markqvist/OpenModem/(threads)

Thread 1 (2020-04-04):

feature request: please add compatibility with Navit

Supermagnum, 2020-04-04:
Navit is a free and open-source, modular, touch screen friendly, car navigation system with GPS tracking, realtime routing engine and support for various vector map formats. It features both a 2D and 3D view of map data.

Navit supports a variety of operating systems and hardware platforms.
It is currently not compatible with APRS.

Navits official web page:
https://www.navit-project.org/

Github page:
https://github.com/navit-gps

Navit Documentation:
http://doxygen.navit-project.org/

Link to the suggestion( patch request):
navit-gps/navit#982

markqvist, 2020-04-06:
I think this makes a lot of sense. I will commit to adding support for Navit to OpenModem. Since the OpenModem hardware also has a slot for a GPS module, and I already wrote the basic GPS driver and NMEA parsing into the OpenModem firmware, it'd be natural if OpenModem could function as both a GPS source for Navit and a APRS modem.

Supermagnum, 2020-04-08:
> I think this makes a lot of sense. I will commit to adding support for Navit to OpenModem. Since the OpenModem hardware also has a slot for a GPS module, and I already wrote the basic GPS driver and NMEA parsing into the OpenModem firmware, it'd be natural if OpenModem could function as both a GPS source for Navit and a APRS modem.

That would be great!
The folks at Navit still have to code the support for APRS symbols,I have no clue when that happens.

Closed 2024-02-29.

Thread 2 (2021-01-12):

Firmware from source code not decode packets.

demonwork, 2021-01-12:
The operation of the firmware obtained from the source code differs from the precompiled firmware. It does not decode packets.
When I connect with the configuration program to the precompiled firmware, in the Audio section I see what is shown in the OpenModem_AFSK1200_v1.05.hex.png screenshot.
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
When I connect the configuration program to the firmware from the source code, in the Audio section I see what is shown in the OpenModem.hex-from-source.png screenshot.
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

Perhaps this is somehow related.
I assembled the modem according to your scheme, but my cardholder is different. When there is no SD card in it, SD_DETECT is high, when the card is inserted, low. So I had to invert the card presence check and compile the firmware from the source code.

Everything works fine with precompiled firmware. Except for working with a SD card.

My build system is Ubuntu 18.04, avr-libc 2.0.0, gcc-avr 5.4.0.

demonwork, 2021-01-17:
Fixed the issue and some enhancement in pull request #3

markqvist, 2021-03-12:
Thanks for reporting it. I normally leave the master branch in a working order, but due to some new drivers, the head of the master branch was not decoding packets. Please always use the sources from the latest tagged release if something is wonky, in rare cases I might be in the middle of something in the head of the master branch ;) Either way, version 1.06 is released now and the issue is resolved. I'll have a look at the pull request later. Thanks for contributing.

Closed 2021-03-12.

Thread 6 (2022-12-28):

Plans to open source board layout files?

spaceinvadr, 2022-12-28:
Hey Mark, I want to start by saying I've been following your work on Reticulum and RNode for several years and am hugely appreciative of everything you have made available to the community. These projects have been hugely inspirational in my own personal projects and I'm looking forward to watching them continue to develop and enable more people to connect without reliance on internet systems.

I'm wondering if you have any plans to open-source the board files to enable people to assemble their own openmodem hardware. I realize this is a product you sell and even releasing the schematic files is generous. If you would rather not that is totally understandable.

markqvist, 2022-12-28:
Thank you very much for your encouraging comments!

That is something I am considering doing, but currently I'm not sure it would add much value, since it is really hard to source several of the parts needed to build the modem, especially the ATmega1284p MCU. I've been working on a redesign to use another chip, but with everything else going on, and priorities putting other work higher, it is not something that is near ready yet.

ahedproductions, 2023-11-10:
Hello!
This CPU is very much available now!
https://www.mouser.bg/ProductDetail/Microchip-Technology/ATMEGA1284P-AU?qs=K8BHR703ZXhSH38LfIFExQ%3D%3D
I would like to up the question.
Thank you!

Closed 2024-02-29.
