markqvist/OpenModem/documentation/Schematic.pdf

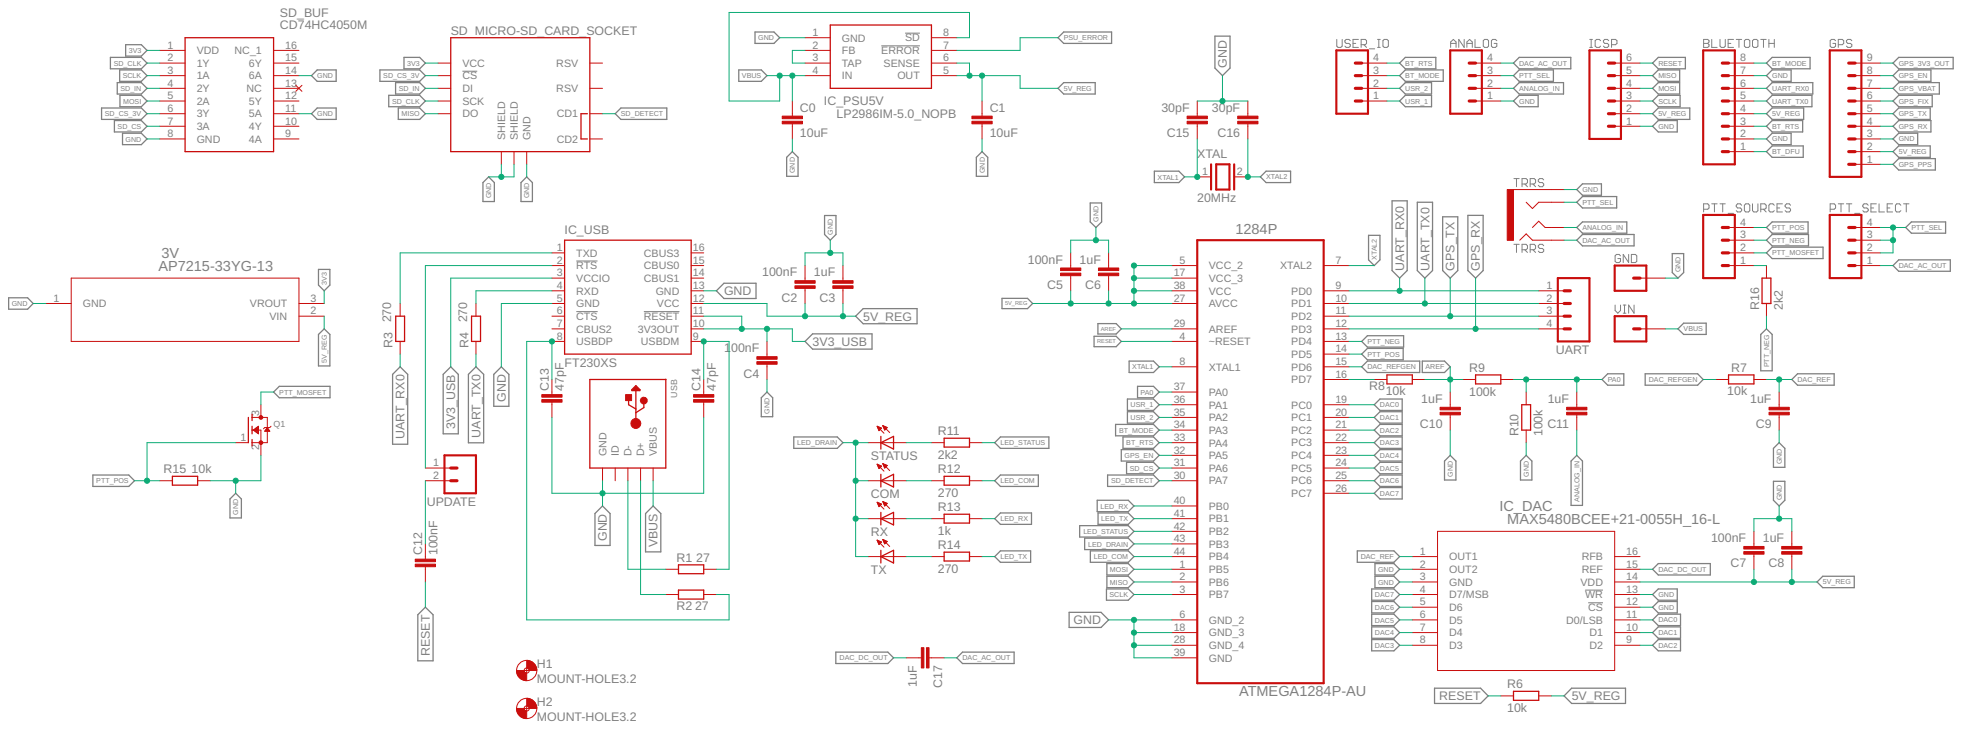
[picture p1: page 1]

RESET | PTT_NEG 14 PD6

USR_2 | DAC1 21 PC3

SD_CS | DAC5 25 PC7
