markqvist/OpenModem/documentation/OpenModem_Production_Layout.pdf

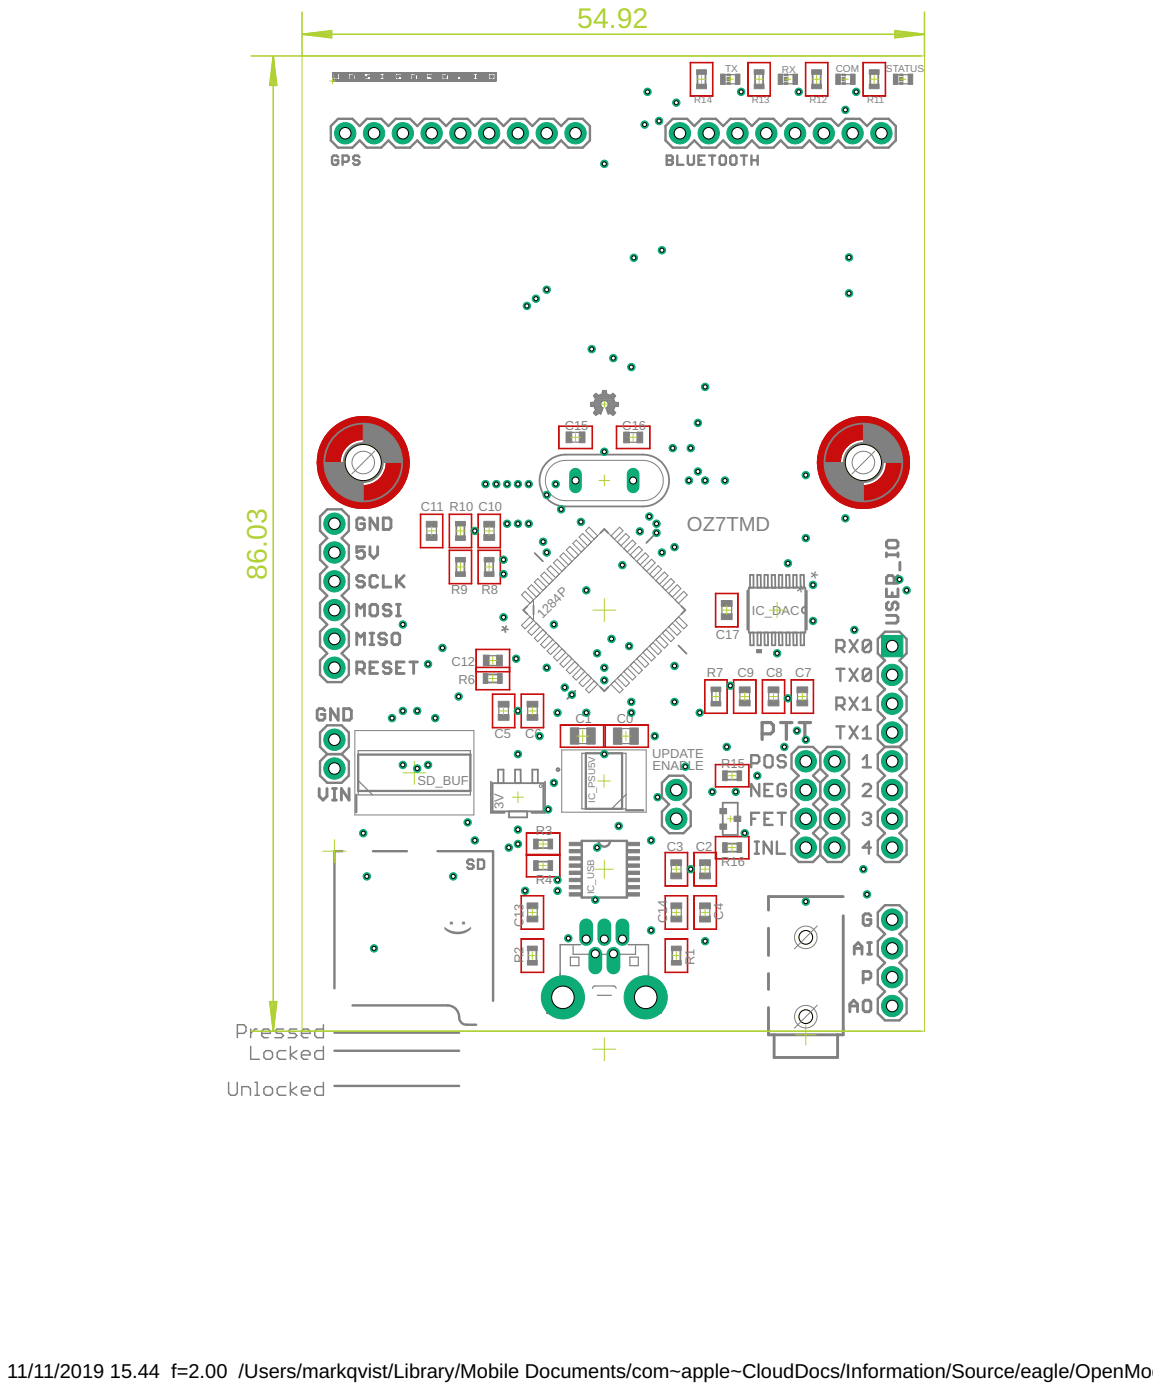
[picture p2: page 1]

11/11/2019 15.44 f=2.00 /Users/markqvist/Library/Mobile Documents/com~apple~CloudDocs/Information/Source/eagle/OpenModem/OpenModem.brd
