markqvist/OpenModem/documentation/OpenModem_Schematic.sch

## EAGLE design documentation/OpenModem_Schematic.sch (2020-04-30)

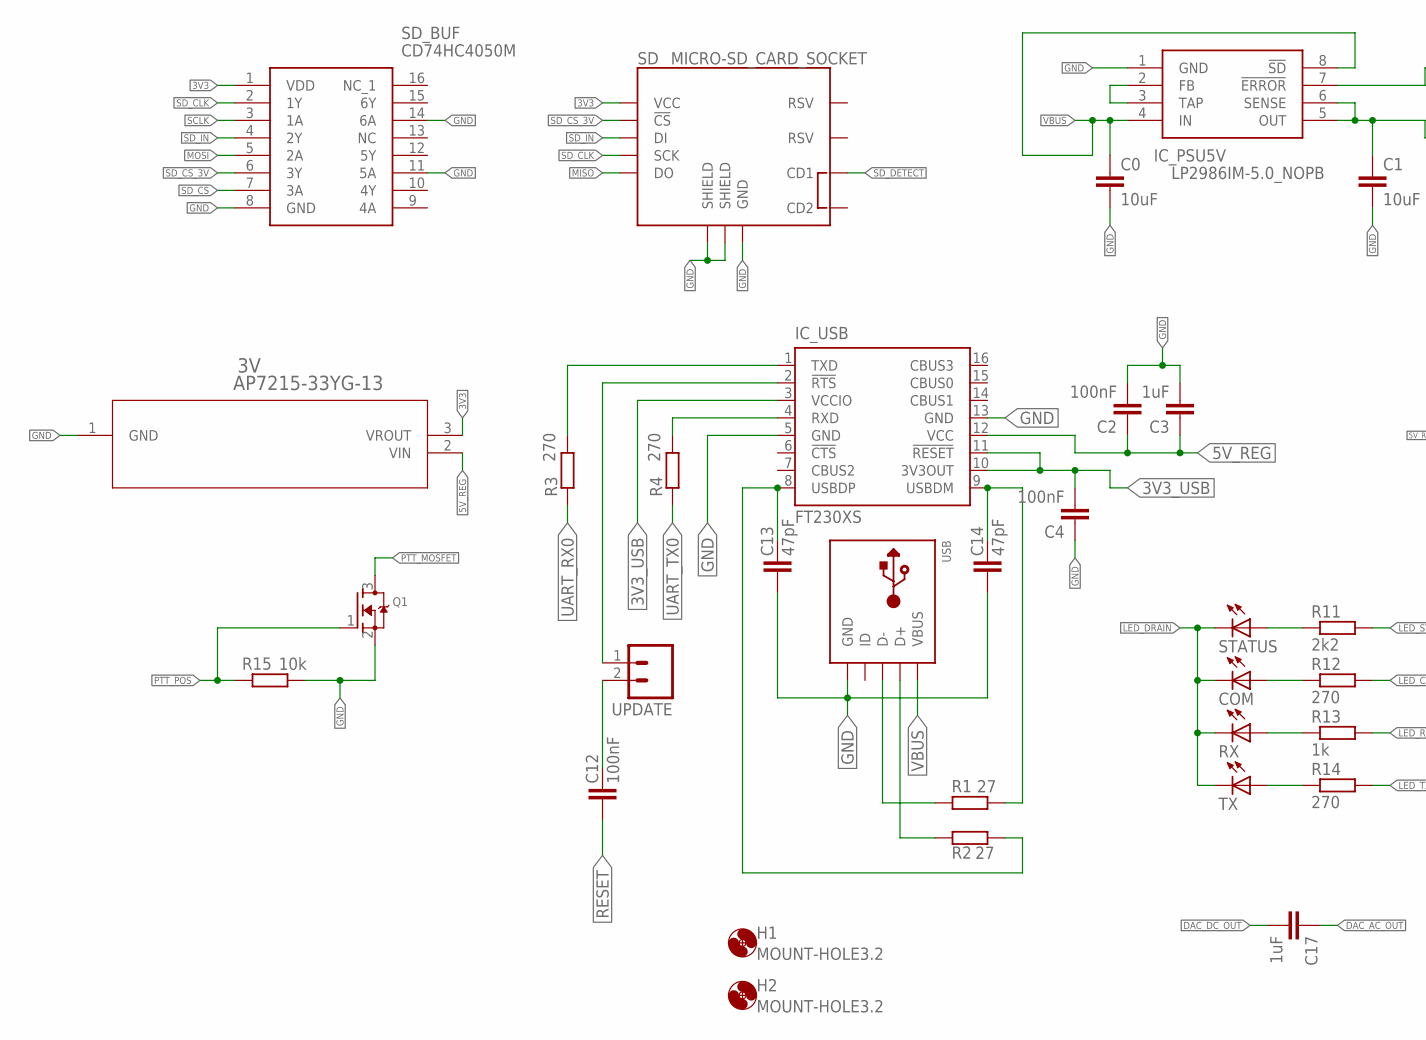
[picture p3: schematic OpenModem_Schematic.sch, part in row 1, column 1]

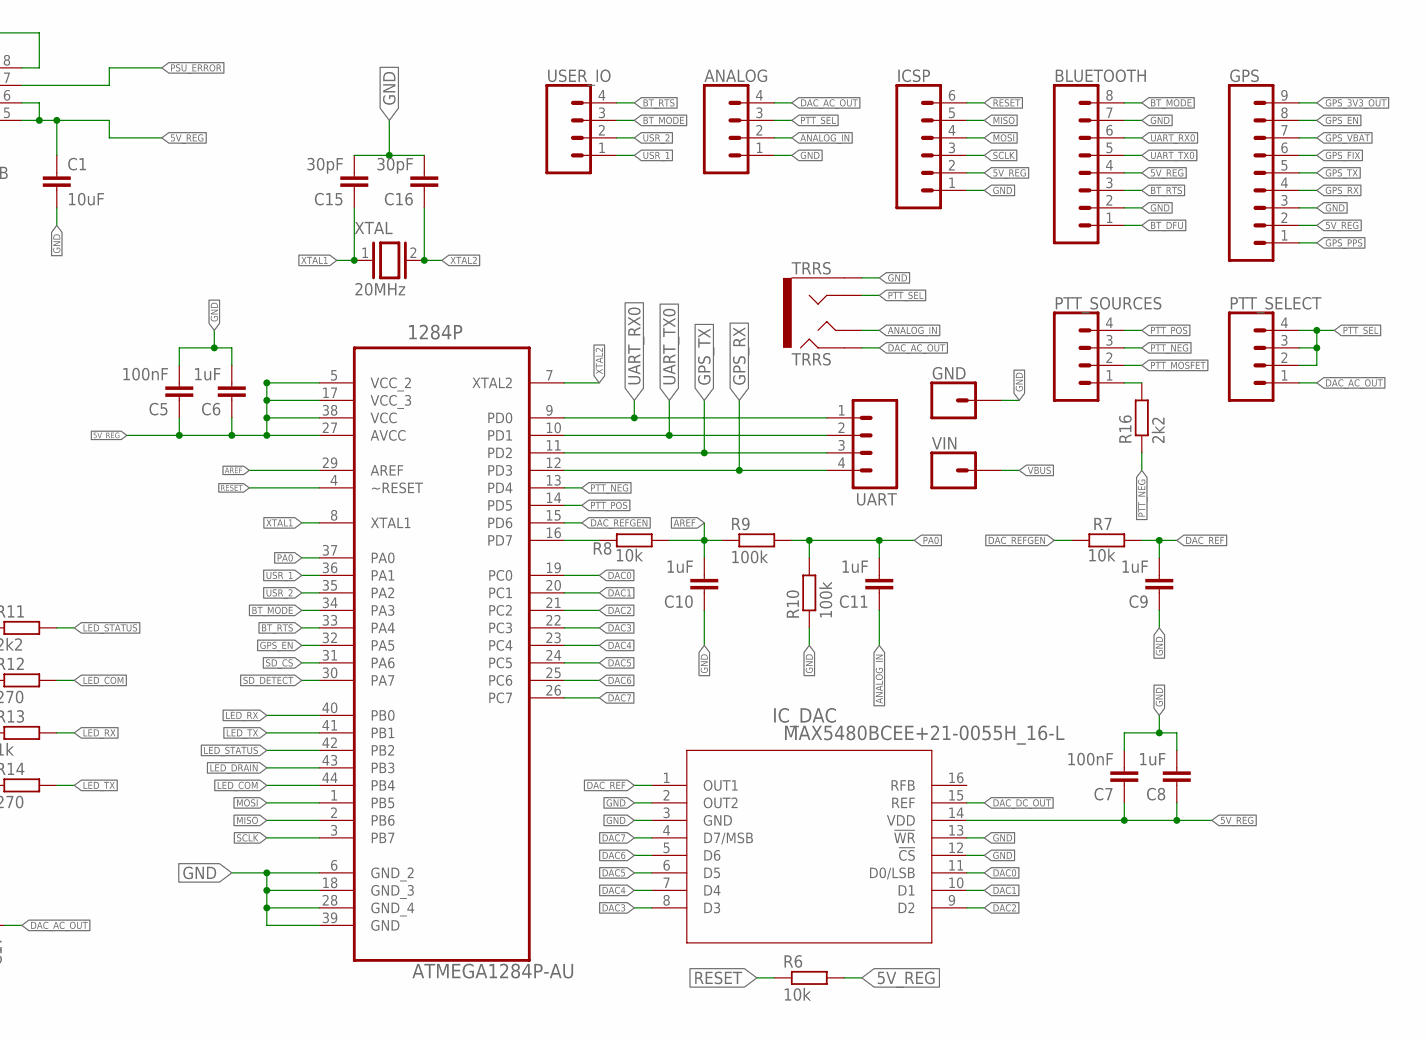
[picture p4: schematic OpenModem_Schematic.sch, part in row 1, column 2]

Parts:
3V: AP7215-33YG-13; SOT89-3L
1284P: ATMEGA1284P-AU; QFP80P1200X1200X120-44N
ANALOG: CONN_04; 1X04
BLUETOOTH: CONN_08"; 1X08
C0, C1: 10uF; C0805
C2, C4, C5, C7, C12: 100nF; C0603
C3, C6, C8, C9, C10, C11, C17: 1uF; C0603
C13, C14: 47pF; C0603
C15, C16: 30pF; C0603
COM: LEDCHIP-LED0603; CHIP-LED0603
GND: CONN_01; 1X01
GPS: CONN_09; 1X09
H1, H2: MOUNT-HOLE3.2; 3,2
ICSP: CONN_06SILK_FEMALE_PTH; 1X06
IC_DAC: MAX5480BCEE+21-0055H_16-L; 21-0055H_16-L
IC_PSU5V: LP2986IM-5.0_NOPB; SOIC127P600X175-8N
IC_USB: FT230XS; SSOP16
PTT_SELECT: CONN_04; 1X04
PTT_SOURCES: CONN_04; 1X04
Q1: MOSFET-NSMALLER; SOT23-SMALLER
R1, R2: 27; R0603
R3, R4, R12, R14: 270; R0603
R6, R7, R8, R15: 10k; R0603
R9, R10: 100k; R0603
R11, R16: 2k2; R0603
R13: 1k; R0603
RX: LEDCHIP-LED0603; CHIP-LED0603
SD: MICRO-SD_CARD_SOCKET; MICRO-SD-SOCKET
SD_BUF: CD74HC4050M; SOIC127P600X175-16N
STATUS: LEDCHIP-LED0603; CHIP-LED0603
TRRS: TRRS; AUDIO_JACK_3.5MM_TRRS_SMD_RA
TX: LEDCHIP-LED0603; CHIP-LED0603
UART: M04PTH; 1X04
UPDATE: M02PTH; 1X02
USB: USBMOLEX; USB-MINIB-THM-MOLEX
USER_IO: CONN_04; 1X04
VIN: CONN_01; 1X01
XTAL: 20MHz; QS

Connections:
3V3: 3V.3 (VROUT), SD.VCC, SD_BUF.1 (VDD)
3V3_USB: C4.2, IC_USB.3 (VCCIO), IC_USB.10 (3V3OUT), IC_USB.11 (!RESET)
5V_REG: 3V.2 (VIN), 1284P.5 (VCC_2), 1284P.17 (VCC_3), 1284P.27 (AVCC), 1284P.38 (VCC), BLUETOOTH.4, C1.1, C2.1, C3.1, C5.1, C6.1, C7.1, C8.1, GPS.2, ICSP.2, IC_DAC.14 (VDD), IC_PSU5V.5 (OUT), IC_PSU5V.6 (SENSE), IC_USB.12 (VCC), R6.2
ADC_REFGEN: 1284P.16 (PD7), R8.1
ANALOG_IN: ANALOG.2, C11.1, TRRS.TIP
AREF: 1284P.29 (AREF), C10.2, R8.2, R9.1
BT_DFU: BLUETOOTH.1
BT_MODE: 1284P.34 (PA3), BLUETOOTH.8, USER_IO.3
BT_RTS: 1284P.33 (PA4), BLUETOOTH.3, USER_IO.4
DAC0: 1284P.19 (PC0), IC_DAC.11 (D0/LSB)
DAC1: 1284P.20 (PC1), IC_DAC.10 (D1)
DAC2: 1284P.21 (PC2), IC_DAC.9 (D2)
DAC3: 1284P.22 (PC3), IC_DAC.8 (D3)
DAC4: 1284P.23 (PC4), IC_DAC.7 (D4)
DAC5: 1284P.24 (PC5), IC_DAC.6 (D5)
DAC6: 1284P.25 (PC6), IC_DAC.5 (D6)
DAC7: 1284P.26 (PC7), IC_DAC.4 (D7/MSB)
DAC_AC_OUT: ANALOG.4, C17.1, PTT_SELECT.1, TRRS.RING2
DAC_DC_OUT: C17.2, IC_DAC.15 (REF)
DAC_REF: C9.2, IC_DAC.1 (OUT1), R7.2
DAC_REFGEN: 1284P.15 (PD6), R7.1
EXT_RESET: C12.2, UPDATE.2
GND: 3V.1 (GND), 1284P.6 (GND_2), 1284P.18 (GND_3), 1284P.28 (GND_4), 1284P.39 (GND), ANALOG.1, BLUETOOTH.2, BLUETOOTH.7, C0.2, C1.2, C2.2, C3.2, C4.1, C5.2, C6.2, C7.2, C8.2, C9.1, C10.1, C13.1, C14.1, C15.2, C16.2, GND.1, GPS.3, ICSP.1, IC_DAC.2 (OUT2), IC_DAC.3 (GND), IC_DAC.12 (!CS), IC_DAC.13 (!WR), IC_PSU5V.1 (GND), IC_USB.5 (GND), IC_USB.13 (GND), Q1.2 (S), R10.1, R15.1, SD.GND, SD.GND1 (SHIELD), SD.GND3 (SHIELD), SD_BUF.8 (GND), SD_BUF.11 (5A), SD_BUF.14 (6A), TRRS.EARTH, USB.GND
GPS_3V3_OUT: GPS.9
GPS_EN: 1284P.32 (PA5), GPS.8
GPS_FIX: GPS.6
GPS_PPS: GPS.1
GPS_RX: 1284P.12 (PD3), GPS.4, UART.4
GPS_TX: 1284P.11 (PD2), GPS.5, UART.3
GPS_VBAT: GPS.7
LED_COM: 1284P.44 (PB4), R12.2
LED_DRAIN: 1284P.43 (PB3), COM.C, RX.C, STATUS.C, TX.C
LED_RX: 1284P.40 (PB0), R13.2
LED_STATUS: 1284P.42 (PB2), R11.2
LED_TX: 1284P.41 (PB1), R14.2
MISO: 1284P.2 (PB6), ICSP.5, SD.DO
MOSI: 1284P.1 (PB5), ICSP.4, SD_BUF.5 (2A)
unnamed: R11.1, STATUS.A
unnamed: COM.A, R12.1
unnamed: R13.1, RX.A
unnamed: R14.1, TX.A
PA0: 1284P.37 (PA0), C11.2, R9.2, R10.2
PSU_ERROR: IC_PSU5V.7 (!ERROR)
PSU_FEEDBACK: IC_PSU5V.2 (FB), IC_PSU5V.3 (TAP)
PTT_MOSFET: PTT_SOURCES.2, Q1.3 (D)
PTT_NEG: 1284P.13 (PD4), PTT_SOURCES.3, R16.1
PTT_NEG_RES: PTT_SOURCES.1, R16.2
PTT_POS: 1284P.14 (PD5), PTT_SOURCES.4, Q1.1 (G), R15.2
PTT_SEL: ANALOG.3, PTT_SELECT.2, PTT_SELECT.3, PTT_SELECT.4, TRRS.RING1
RESET: 1284P.4 (~RESET), C12.1, ICSP.6, R6.1
SCLK: 1284P.3 (PB7), ICSP.3, SD_BUF.3 (1A)
SD_CLK: SD.SCLK (SCK), SD_BUF.2 (1Y)
SD_CS: 1284P.31 (PA6), SD_BUF.7 (3A)
SD_CS_3V: SD.CS (!CS), SD_BUF.6 (3Y)
SD_DETECT: 1284P.30 (PA7), SD.CD1
SD_IN: SD.DI, SD_BUF.4 (2Y)
UART_RX0: 1284P.9 (PD0), BLUETOOTH.6, R3.1, UART.1
UART_TX0: 1284P.10 (PD1), BLUETOOTH.5, R4.1, UART.2
USB_DM: C14.2, IC_USB.9 (USBDM), R1.1
USB_DM_IN: R1.2, USB.D-
USB_DP: C13.2, IC_USB.8 (USBDP), R2.1
USB_DP_IN: R2.2, USB.D+
USB_RTS: IC_USB.2 (!RTS), UPDATE.1
USB_UART_RX: IC_USB.4 (RXD), R4.2
USB_UART_TX: IC_USB.1 (TXD), R3.2
USR_1: 1284P.36 (PA1), USER_IO.1
USR_2: 1284P.35 (PA2), USER_IO.2
VBUS: C0.1, IC_PSU5V.4 (IN), IC_PSU5V.8 (!SD), USB.VBUS, VIN.1
XTAL1: 1284P.8 (XTAL1), C15.1, XTAL.1
XTAL2: 1284P.7 (XTAL2), C16.1, XTAL.2
