markqvist/OpenModem/hardware/Bluetooth.h

#ifndef BT_H
#define BT_H

#include <avr/io.h>
#include <string.h>
#include <stdlib.h>
#include <stdbool.h>
#include <stdio.h>
#include "device.h"
#include "util/time.h"
#include "hardware/Serial.h"

void bluetooth_init(void);
bool bluetooth_enabled(void);


#endif
