markqvist/OpenModem/(commit log)

2018-12-29 Work on sample rate independency
2018-12-29 Filters reworked for new samplerate
    [AFSK.c, AFSK.h, AX25.c, device.h]
2018-12-31 Filter work
2019-01-04 Implemented variable VREF for DAC and ADC
2019-01-05 Independent ADC and DAC sample rates
2019-01-07 Frame size increased to ethernet-compliant MTU
2019-01-12 LED driver work
2019-01-12 LED driver implemented
2019-01-29 Added bluetooth and user I/O drivers
2019-02-04 GPS driver implemented
2019-02-04 AES crypto driver
2019-02-08 AES padding and queue fix
    [KISS.c, device.h]
2020-01-26 Added schematic
2020-04-30 Added hardware documentation
    [OpenModem_Schematic.sch]
2020-05-28 Serial interrupt
2020-06-01 Fixed FIFO16 buffer and inits
    [KISS.c, device.h]
2020-06-01 Fixed GPS serial querying
    [Serial.c, device.h]
2020-10-22 GPS init sequence fix
    [Bluetooth.h, GPS.c, GPS.h]
2020-10-23 Added BME280 driver
